skkippitty/bench-light-controller/docs/schematics/stage2-pwm-toggle.png

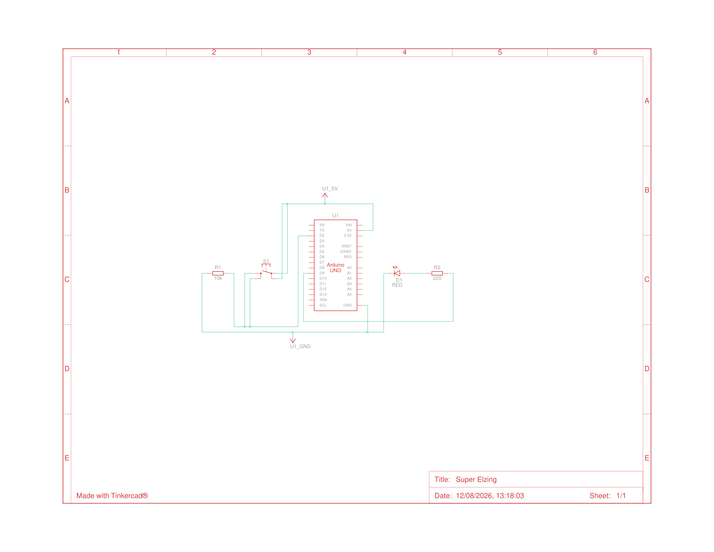
docs/schematics/stage2-pwm-toggle.png
