skkippitty/bench-light-controller/docs/schematics/stage3-adc-potentiometer.png

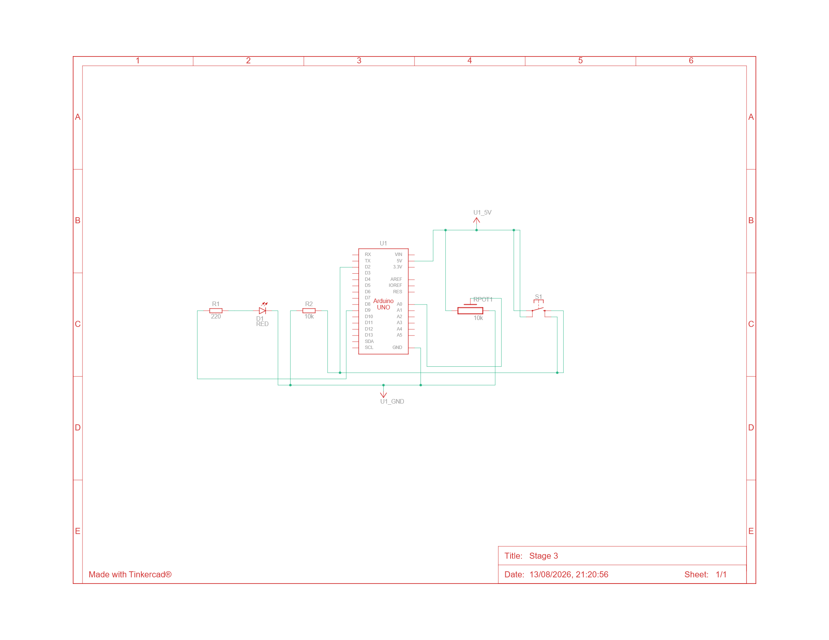
docs/schematics/stage3-adc-potentiometer.png
