skkippitty/bench-light-controller/docs/schematics/stage4-mosfet-load.png

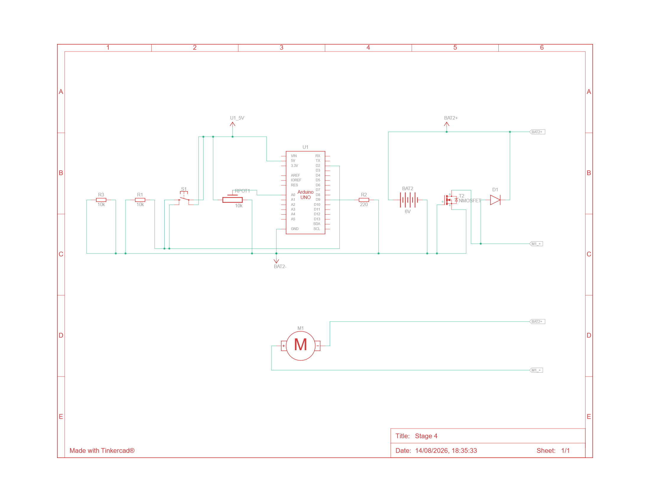
docs/schematics/stage4-mosfet-load.png
