skkippitty/bench-light-controller/(commit log)

2026-08-11 Add Stage 1 and 2 measurement plan and design decisions
2026-08-12 Add Stage 1 and Stage 2 firmware sketches
    Stage 1: direct button-to-LED passthrough on pins 2 and 13, with the
    raw button state echoed over serial for measurement.
    Stage 2: latching toggle driving a PWM output on pin 9, with a 50 ms
    debounce window and brightness held in a named constant so it can be
    varied without touching the write call.
    Replaces the .gitkeep placeholders in both stage directories.
    [stage2-pwm-toggle.ino]
2026-08-12 Add Stage 2 circuit schematic
    Schematic for the Stage 2 toggle/PWM build, exported from Tinkercad and
    converted from PDF to PNG so it renders inline rather than needing a
    download.
    Circuit as drawn: S1 switches 5 V onto D2, with R1 10k from that node to
    ground as a pull-down, so the input reads LOW at rest and HIGH while
    pressed. D9 drives D1 through R2 220R to ground.
    Replaces the .gitkeep placeholder in docs/schematics.
2026-08-13 Add Stage 3 ADC and potentiometer firmware
2026-08-13 Add Stage 3 circuit schematic
2026-08-14 Add Stage 4 circuit schematic
2026-08-14 Add Stage 4 MOSFET load switching firmware
2026-08-17 Add Stage 4 hardware debugging log and design decisions
2026-08-17 Fix markdown formatting in Stage 4 documentation
2026-08-17 Bold remaining lead-ins in Stage 4 documentation
2026-08-17 Record gate drive measurement and confirm MOSFET selection
2026-08-17 Reconcile README with Stage 4 findings and restore outstanding rows
2026-08-17 Update Stage 4 measurement plan preamble
